rsoo12/Wearable-Haptics-Device/Data_Processing/graphs/Overground.png

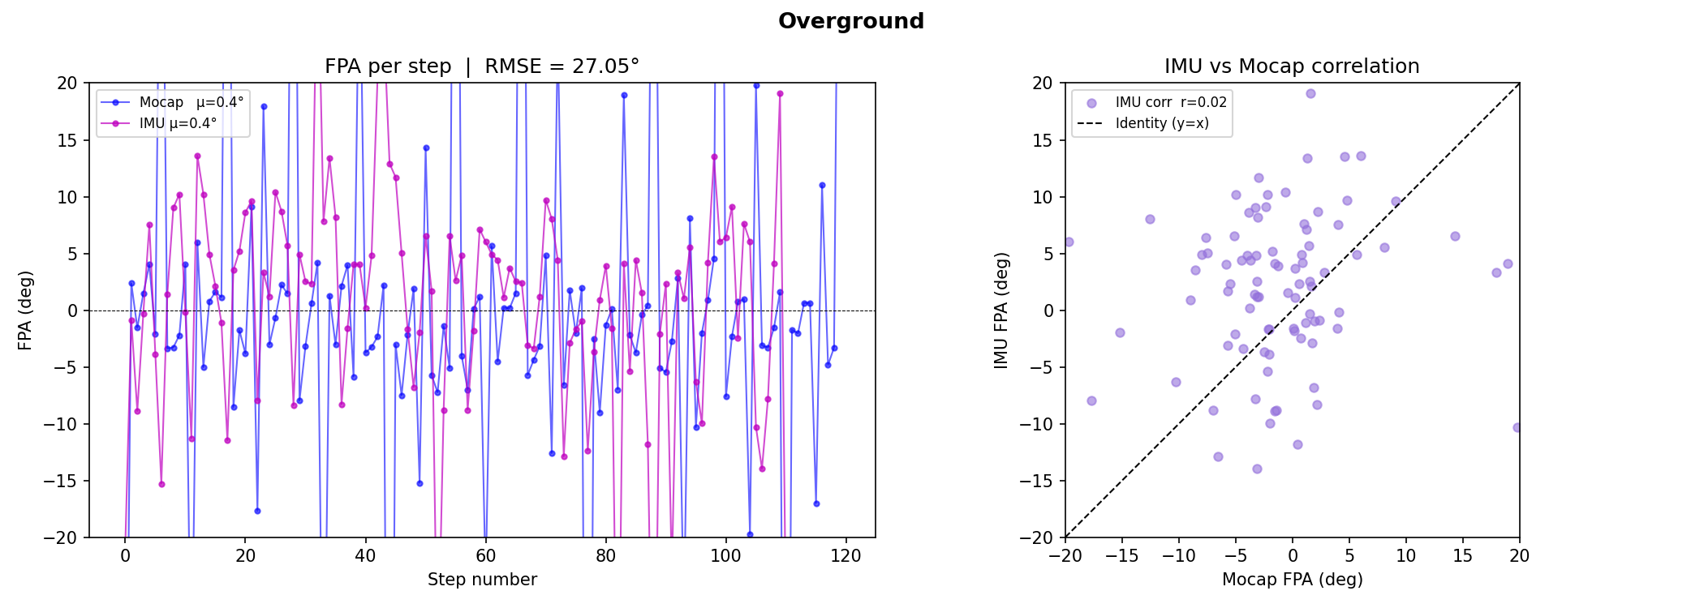
Data_Processing/graphs/Overground.png
