rsoo12/Wearable-Haptics-Device/Data_Processing/graphs/Rhea_All_Correlation.png

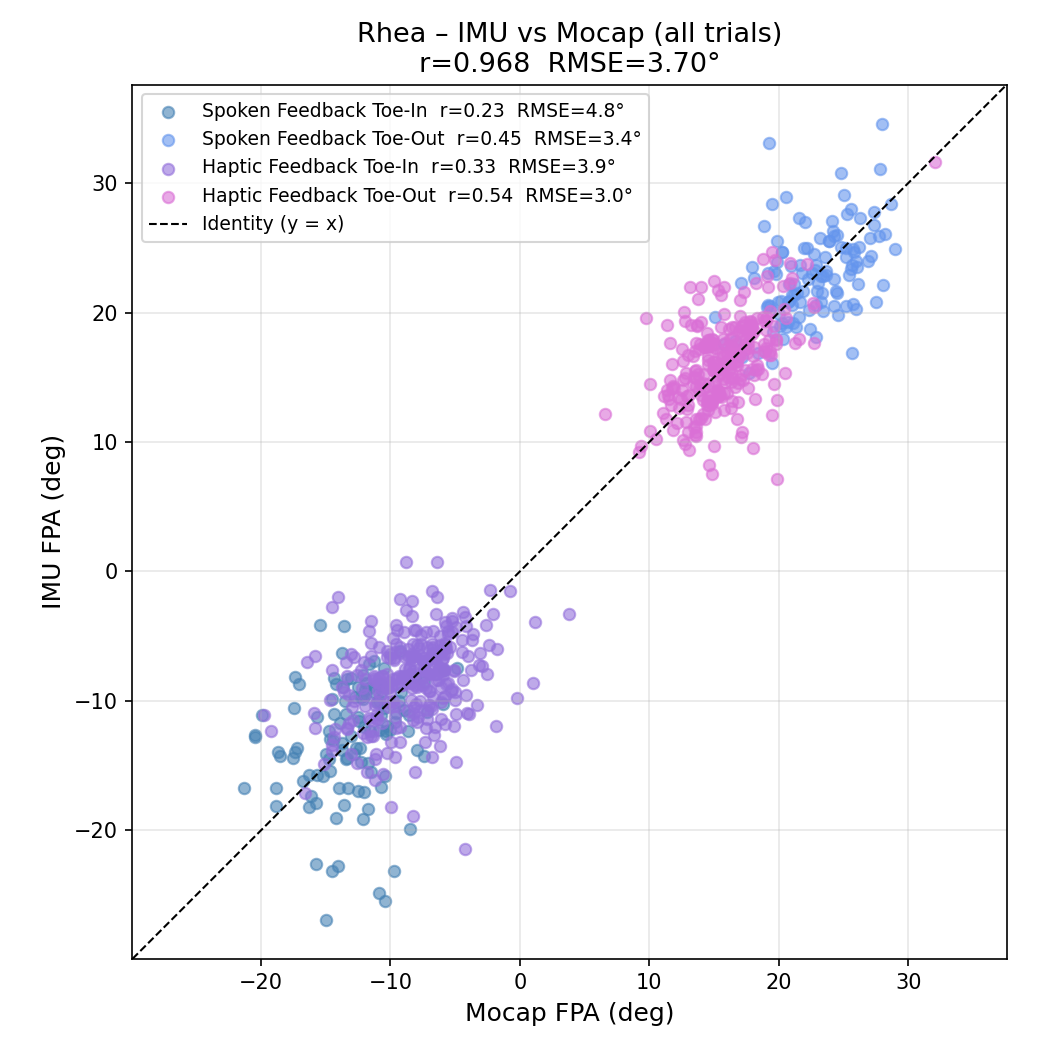
Data_Processing/graphs/Rhea_All_Correlation.png
