rsoo12/Wearable-Haptics-Device/Data_Processing/graphs/Rhea_Baseline_ToeOut.png

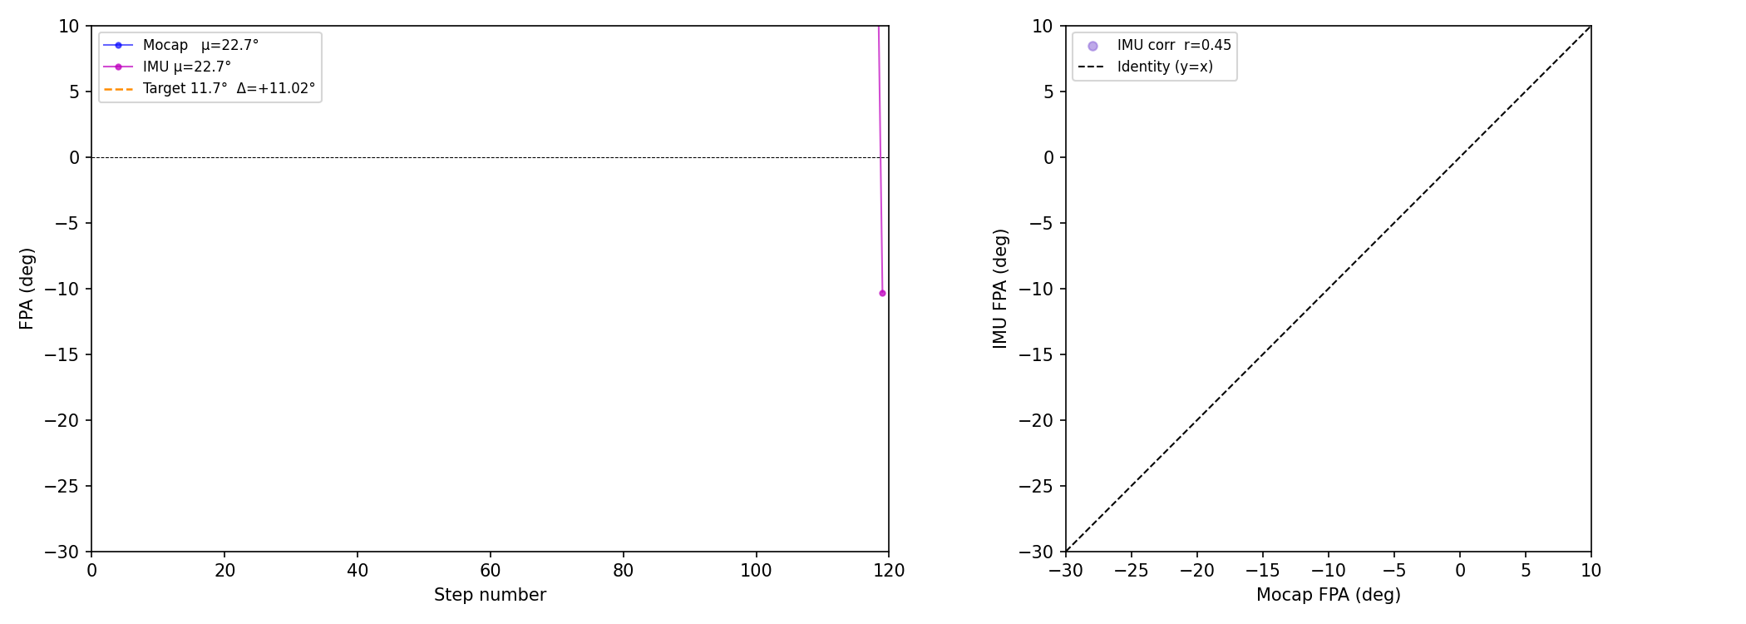
Data_Processing/graphs/Rhea_Baseline_ToeOut.png
