rsoo12/Wearable-Haptics-Device/Data_Processing/graphs/Rhea_Haptic_ToeIn.png

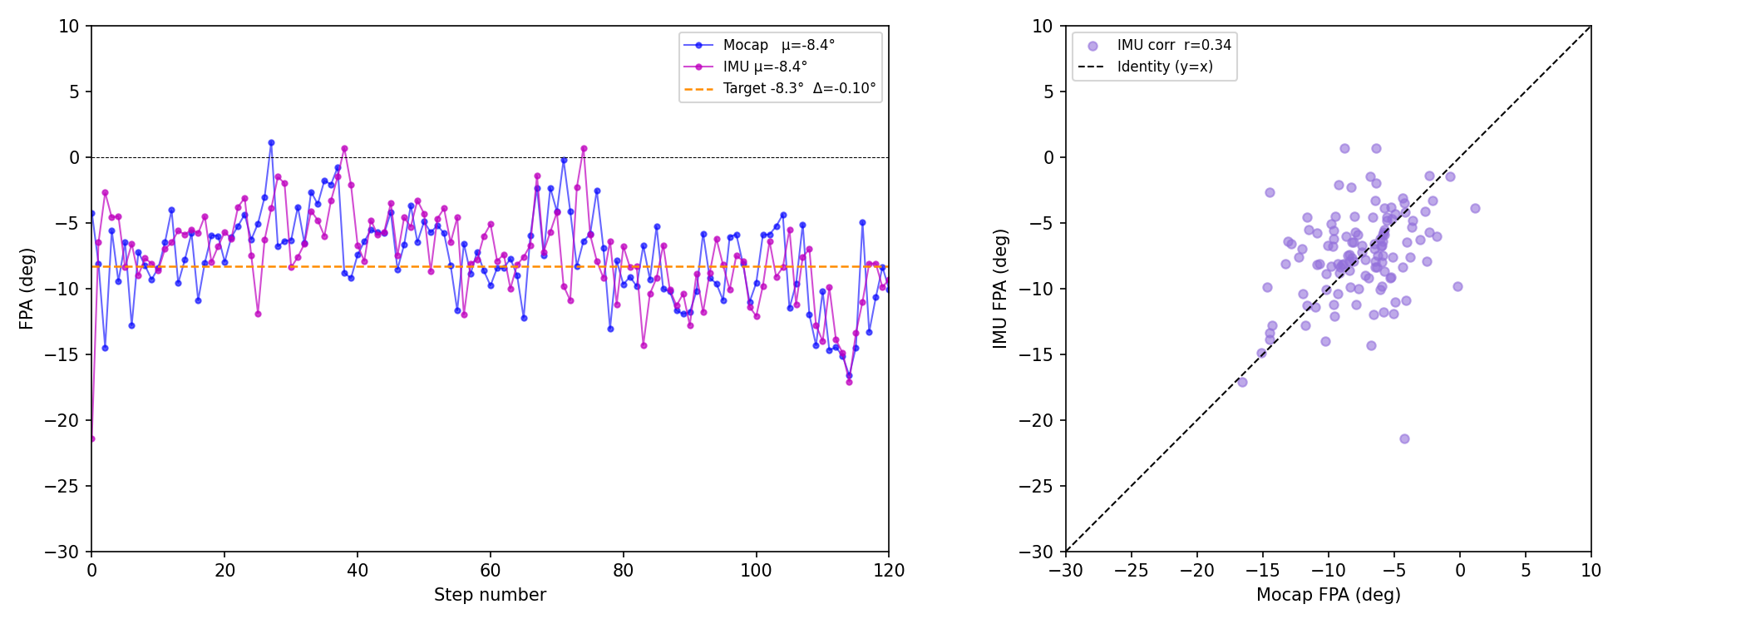
Data_Processing/graphs/Rhea_Haptic_ToeIn.png
