rsoo12/Wearable-Haptics-Device/Data_Processing/graphs/Treadmill_Fast.png

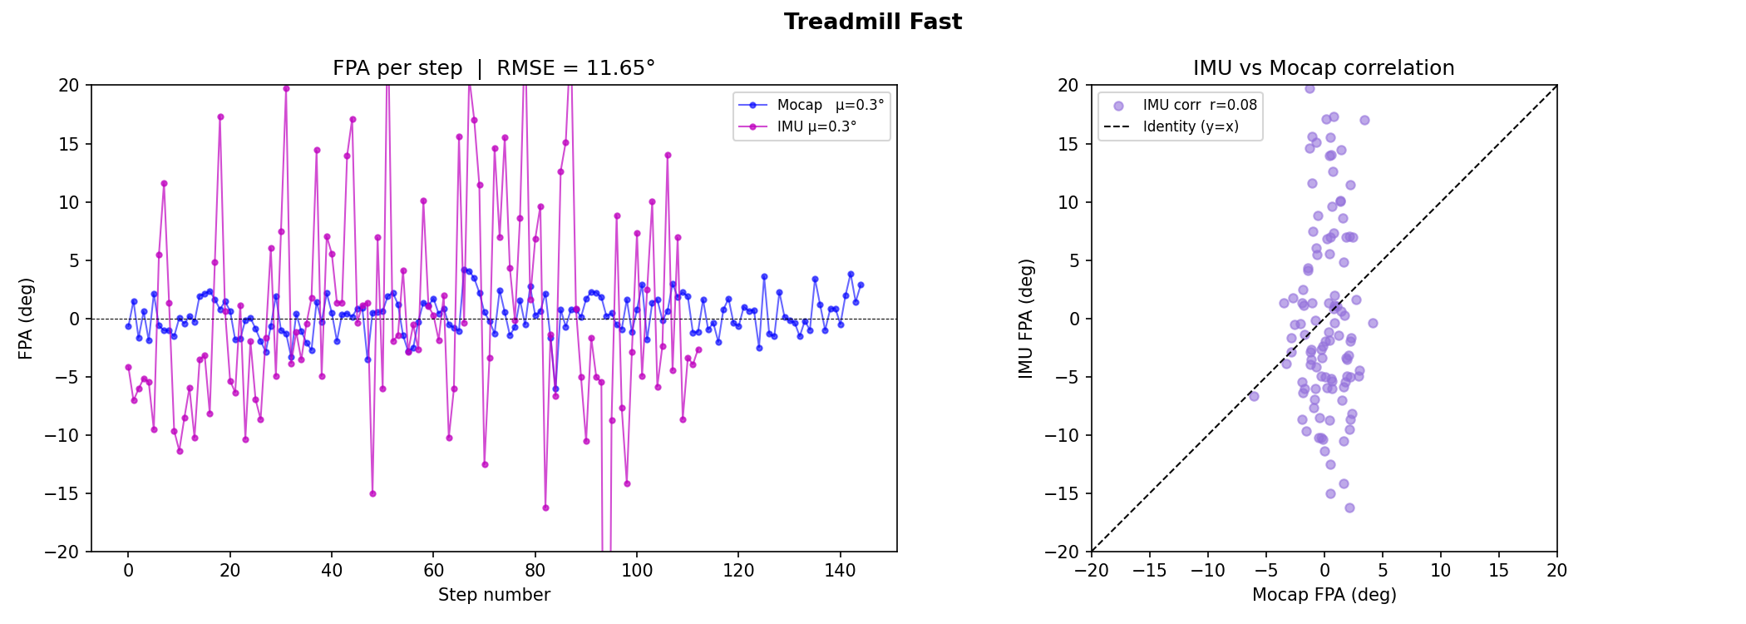
Data_Processing/graphs/Treadmill_Fast.png
