rsoo12/Wearable-Haptics-Device/Data_Processing/graphs/Treadmill_Normal.png

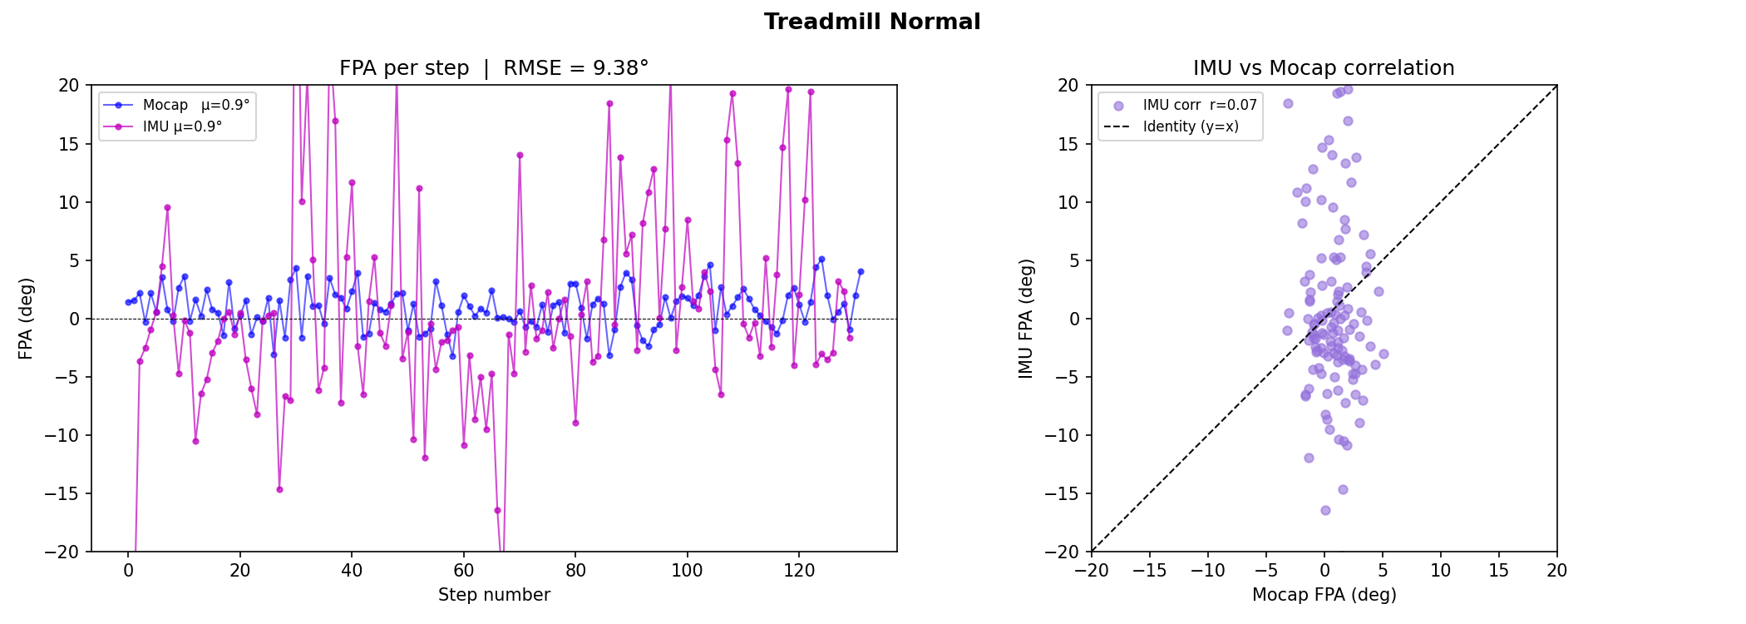
Data_Processing/graphs/Treadmill_Normal.png
