rsoo12/Wearable-Haptics-Device/Data_Processing/graphs/Treadmill_Slow.png

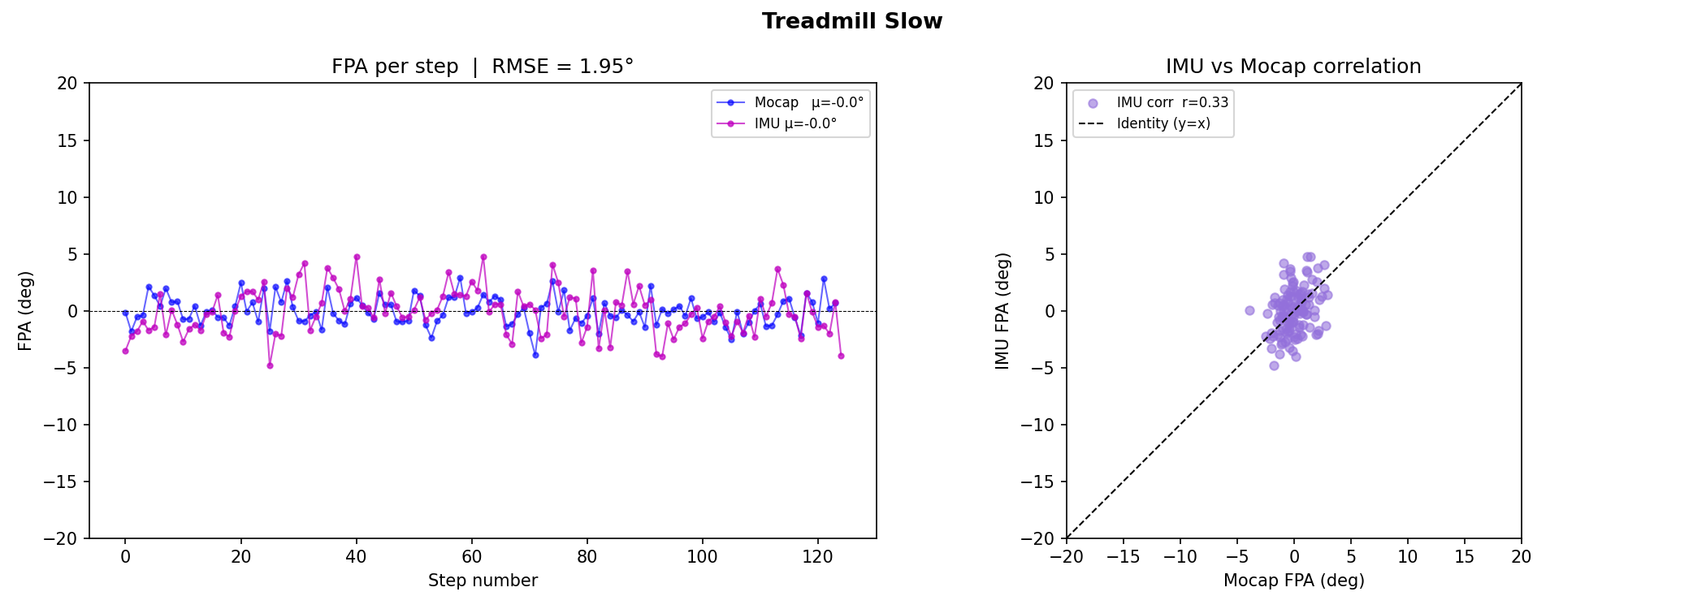
Data_Processing/graphs/Treadmill_Slow.png
