rsoo12/Wearable-Haptics-Device/(commit log)

2025-04-19 data written to csv file, example script for connecting to 2 devices
    [plottingData.csv]
2025-04-19 able to plot data received from 2 devices
2026-02-05 Put everything into one folder
    [plottingData.csv]
2026-02-05 actually put everything into Bluetooth folder
    [plottingData.csv]
2026-02-08 added code for MCU (LRA commands and getting accelerometer data from IMU)
2026-02-11 Refactor MCU/code.py for IMU and haptic integration
    Updated code to include IMU and haptic driver functionality, with additional comments and structure.
2026-02-11 Uncomment code for BLE and IMU functionality
2026-02-13 Refactor IMU initialization and BLE data handling
2026-02-21 run bluetooth,py to connect to device with laptop
2026-03-25 cleaned up bluetooth files, added uv as package manager
    [plottingData.csv]
2026-03-30 mock ui cards for current session, history, and insights pages
2026-04-04 added write to CSV file called "fpa_log.csv" along with print, added it to gitignore
2026-04-04 changed IMU to send at 100 Hz (should make this a config variable so that the change becomes distributed)
2026-04-04 changes vqf_processor to use 100 Hz datarate instead of max (180 Hz)
2026-04-04 bluetooth.py can now connect to multiple devices, updated vqf processor to work with updates
2026-04-06 ignore generic logs, write IMU data into logs, added real trial data to repo
    [Trial_1_Baseline_OvergroundWalking_Lakshmi.csv, Trial_1_Baseline_TreadmillWalking_Lakshmi.csv, Trial_2_Baseline_OvergroundWalking_Lakshmi.csv, Trial_2_Faster_TreadmillWalking_Lakshmi.csv, Trial_3_Slower_TreadillWalking_Lakshmi.csv]
2026-04-13 app: 2 device connection
2026-04-13 added 30 second calibration option
2026-04-15 app: readded 2-device connection, added draft RX/TX pipeline
2026-04-19 added Data Processing code, data and scripts
    [Trial_1_Baseline_OvergroundWalking_Lakshmi.csv, Trial_1_Baseline_TreadmillWalking_Kaitlyn.csv, Trial_1_Baseline_TreadmillWalking_Lakshmi.csv, Trial_1_Haptic_TreadmillWalking_ToeIn_Rhea.csv, Trial_1_Haptic_TreadmillWalking_ToeOut_Rhea.csv, Trial_1_Retention_ToeIn_Rhea.csv, Trial_1_Retention_ToeOut_Rhea.csv, Trial_1_Slow_TreadmillWalking_Rhea.csv]
2026-04-19 Added README for data processing to exactly replicate the data analysis for the mocap v IMU experiments we've done
2026-04-19 deleted old data artifact folder and updated README
    [t0_static_pose_001.csv]
2026-04-19 deleted useless utils and renamed the data_processing folder so its easier to see/use
    [Trial_1_Baseline_OvergroundWalking_Lakshmi.csv, Trial_1_Baseline_TreadmillWalking_Lakshmi.csv, Trial_1_Haptic_TreadmillWalking_ToeIn_Rhea.csv, Trial_1_Haptic_TreadmillWalking_ToeOut_Rhea.csv, Trial_1_Slow_TreadmillWalking_ToeIn_Rhea.csv, Trial_1_Slow_TreadmillWalking_ToeOut_Rhea.csv, Trial_2_Faster_TreadmillWalking_Lakshmi.csv, Trial_3_Slower_TreadillWalking_Lakshmi.csv]
2026-04-21 2 device connection with tx and rx
2026-04-27 updated shank mounted wearable to use LRA library rather than the default ERM
2026-04-29 updated to remove the steps counted from the calibration hops
2026-05-02 file that is written to (for reference for base_fpa after calibration)
    [base_fpa.csv]
2026-05-02 takes all the different sessions with feedback and plots correlation between mocap and IMU
2026-05-02 updated folder names to be more logical
    [Trial_1_Baseline_OvergroundWalking_Lakshmi.csv, Trial_1_Baseline_TreadmillWalking_Kaitlyn.csv, Trial_1_Baseline_TreadmillWalking_Lakshmi.csv, Trial_1_Haptic_TreadmillWalking_ToeIn_Rhea.csv, Trial_1_Haptic_TreadmillWalking_ToeOut_Rhea.csv, Trial_1_Retention_ToeIn_Rhea.csv, Trial_1_Retention_ToeOut_Rhea.csv, Trial_1_Slow_TreadmillWalking_Rhea.csv]
2026-05-02 used left and right instead of toe out and toe in since it changes based on what leg the device is put on
2026-05-22 added app documentation
    [Trial_1_Baseline_OvergroundWalking_Lakshmi.csv, Trial_1_Baseline_TreadmillWalking_Kaitlyn.csv, Trial_1_Baseline_TreadmillWalking_Lakshmi.csv, Trial_1_Haptic_TreadmillWalking_ToeIn_Rhea.csv, Trial_1_Haptic_TreadmillWalking_ToeOut_Rhea.csv, Trial_1_Retention_ToeIn_Rhea.csv, Trial_1_Retention_ToeOut_Rhea.csv, Trial_1_Slow_TreadmillWalking_Rhea.csv]
2026-05-22 last updates
    [fpa_log.csv]
